Kulihrasek456/PID-thermostat-MatProject/Dokumentace/Ostatni/TestSetup.png

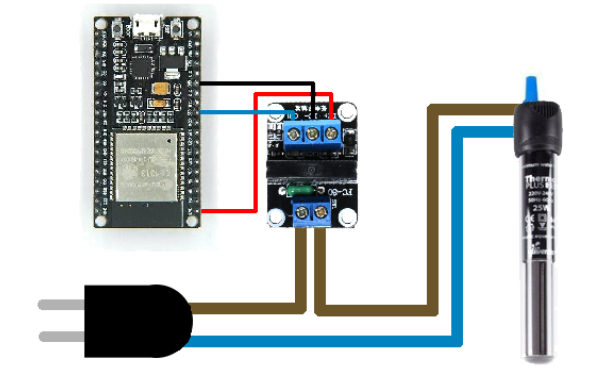
Dokumentace/Ostatni/TestSetup.png
