Kulihrasek456/PID-thermostat-MatProject/Dokumentace/Stránky/IMG_2406.jpg

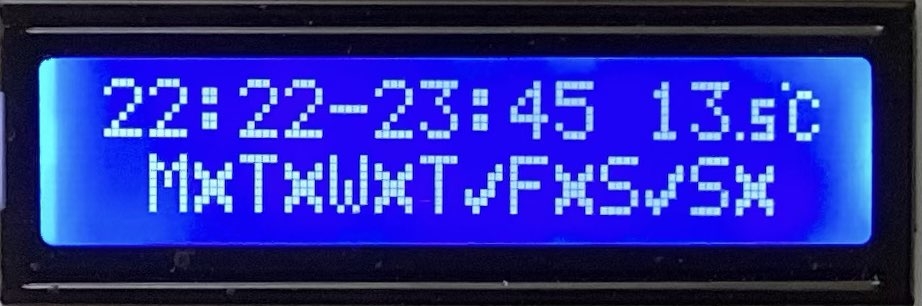
Dokumentace/Stránky/IMG_2406.jpg
