Kulihrasek456/PID-thermostat-MatProject/Dokumentace/Ostatni/1679677724410.jpg

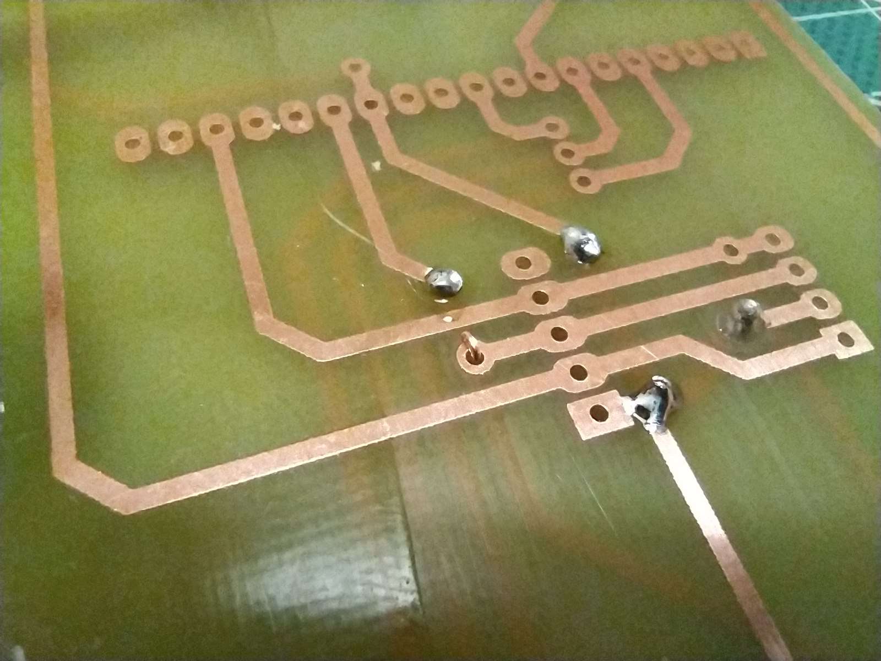
Dokumentace/Ostatni/1679677724410.jpg
