Kulihrasek456/PID-thermostat-MatProject/Dokumentace/Ostatni/1679680318831.jpg

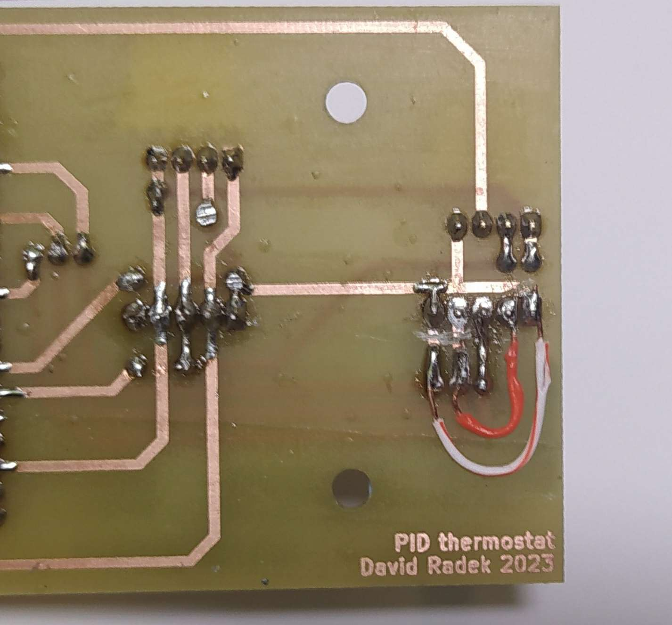
Dokumentace/Ostatni/1679680318831.jpg
