Kulihrasek456/PID-thermostat-MatProject/Dokumentace/Ostatni/Case1.png

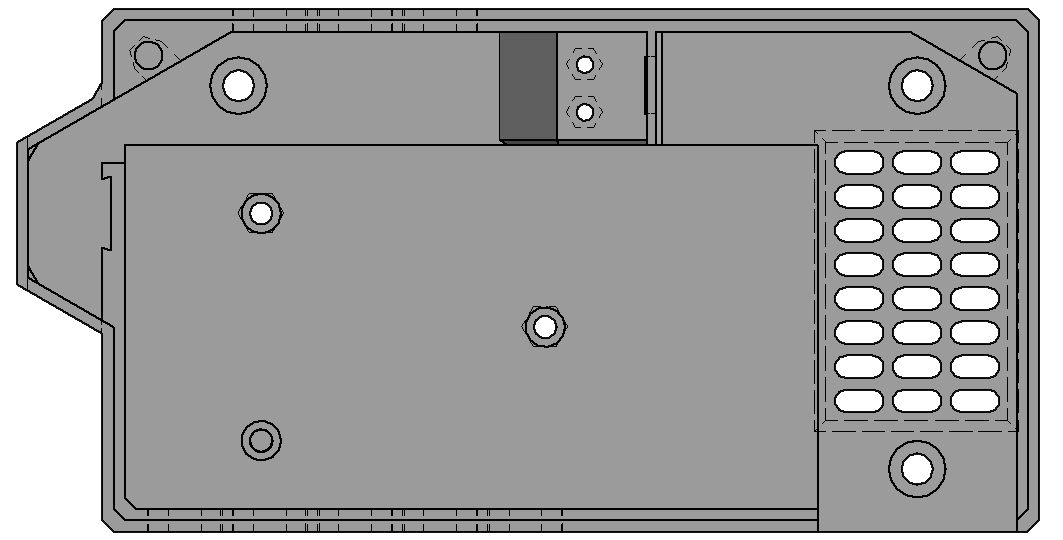
Dokumentace/Ostatni/Case1.png
