Kulihrasek456/PID-thermostat-MatProject/Dokumentace/Ostatni/Case2.png

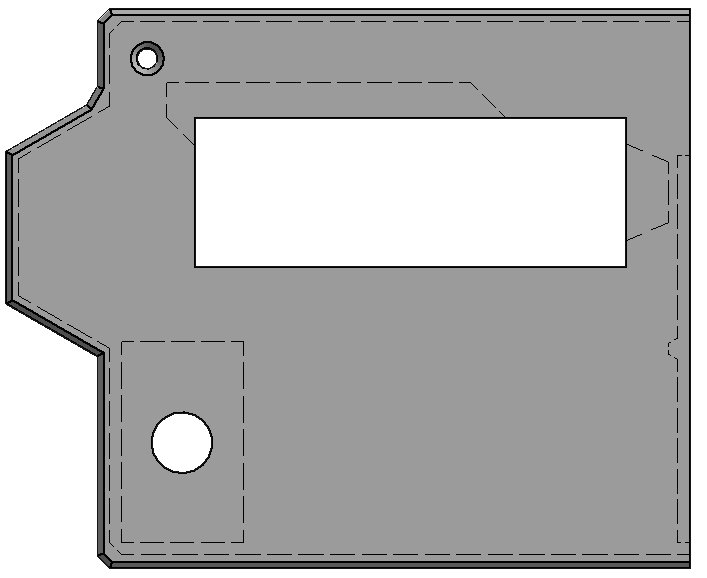
Dokumentace/Ostatni/Case2.png
