Kulihrasek456/PID-thermostat-MatProject/Dokumentace/Ostatni/Case3.png

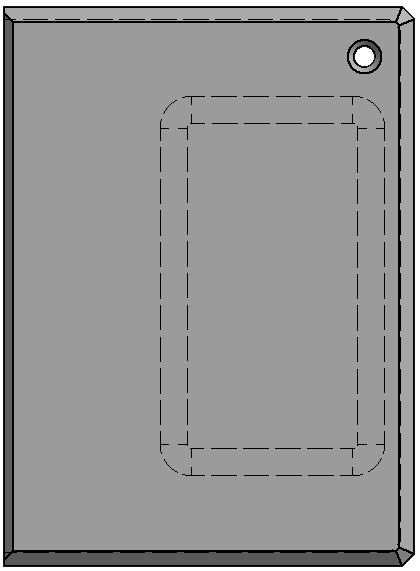
Dokumentace/Ostatni/Case3.png
