Kulihrasek456/PID-thermostat-MatProject/Dokumentace/Ostatni/CaseALl.png

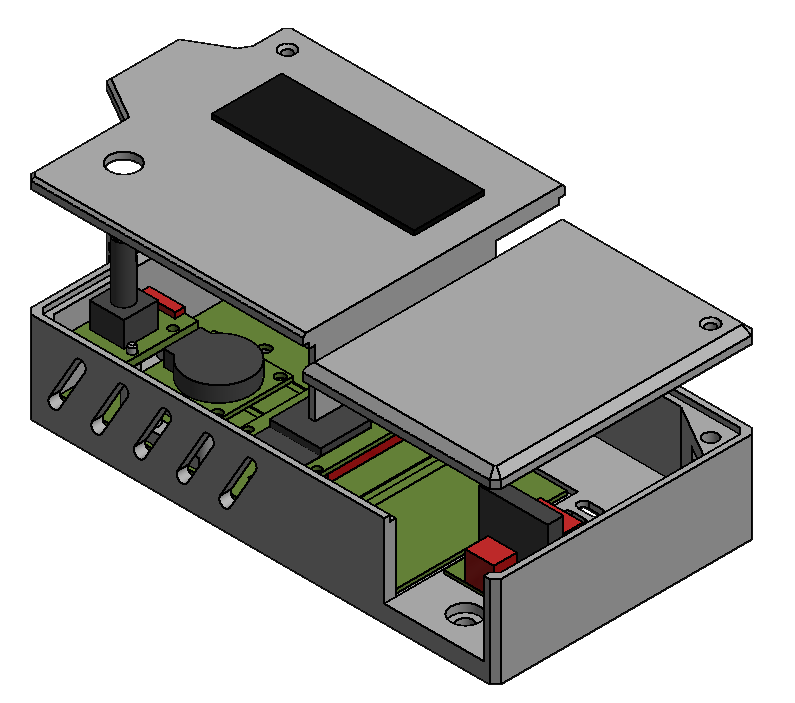
Dokumentace/Ostatni/CaseALl.png
