Kulihrasek456/PID-thermostat-MatProject/Dokumentace/Ostatni/CaseComposite.png

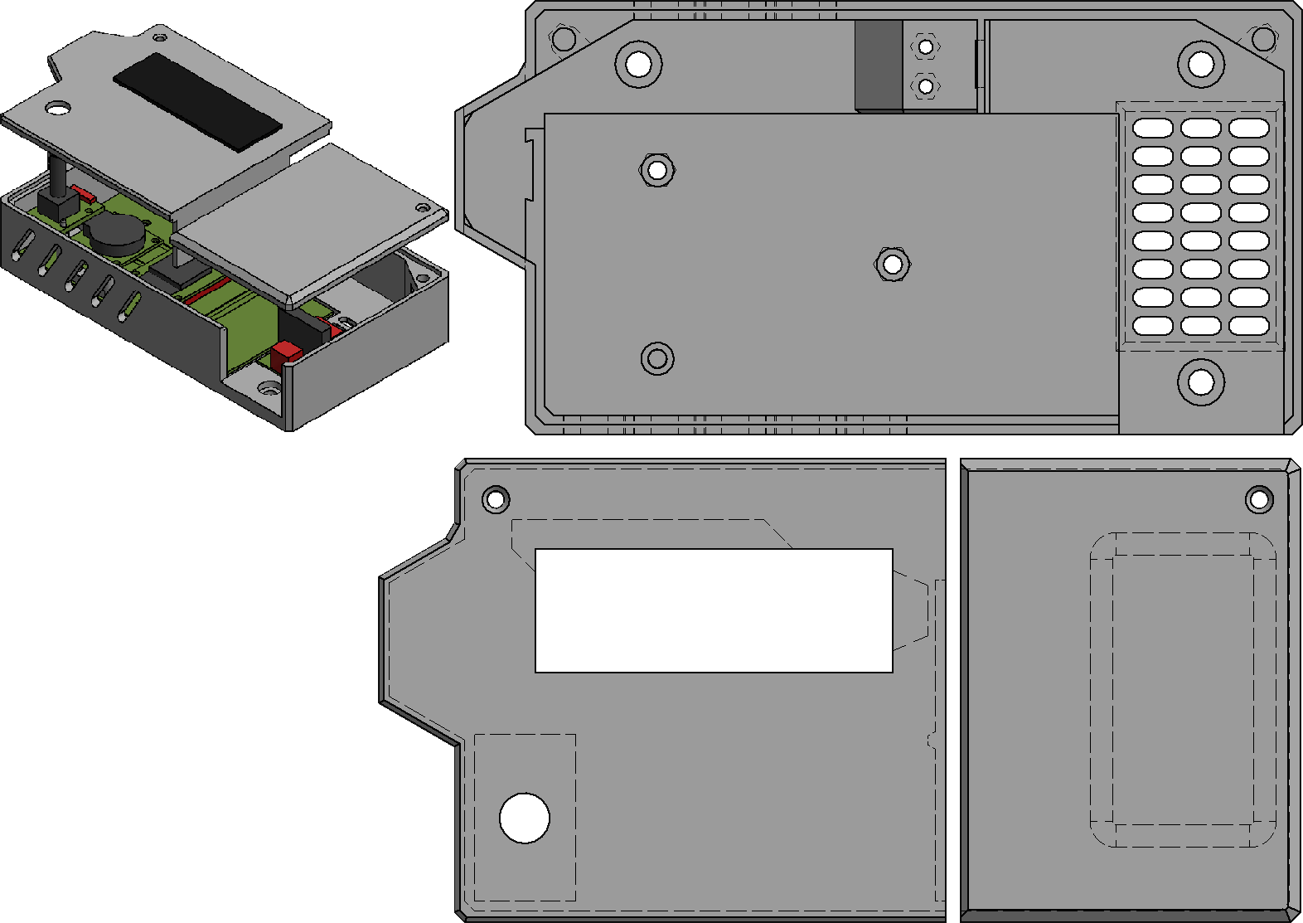
Dokumentace/Ostatni/CaseComposite.png
