Kulihrasek456/PID-thermostat-MatProject/Dokumentace/Ostatni/IMG_2393.jpg

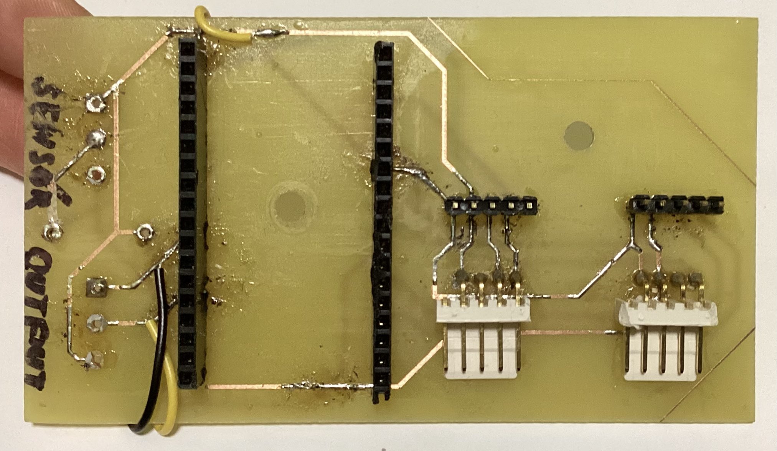
Dokumentace/Ostatni/IMG_2393.jpg
