Kulihrasek456/PID-thermostat-MatProject/Dokumentace/Ostatni/IMG_2394.jpg

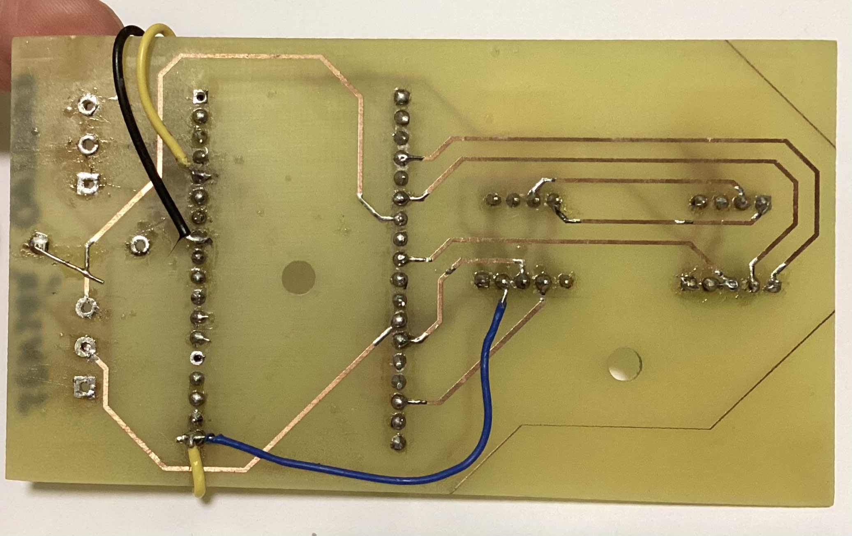
Dokumentace/Ostatni/IMG_2394.jpg
