Kulihrasek456/PID-thermostat-MatProject/Dokumentace/Ostatni/IMG_2408.jpg

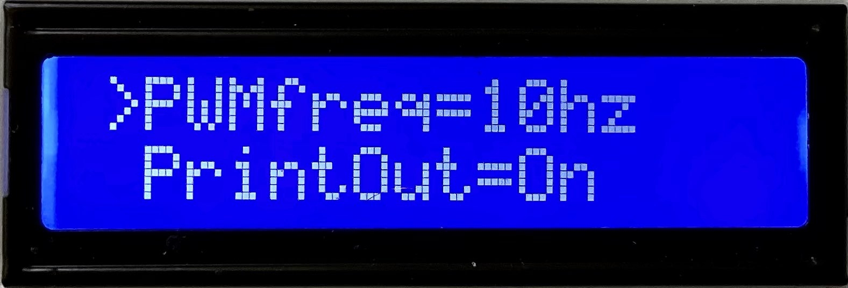
Dokumentace/Ostatni/IMG_2408.jpg
