Kulihrasek456/PID-thermostat-MatProject/Dokumentace/Ostatni/IMG_2410.jpg

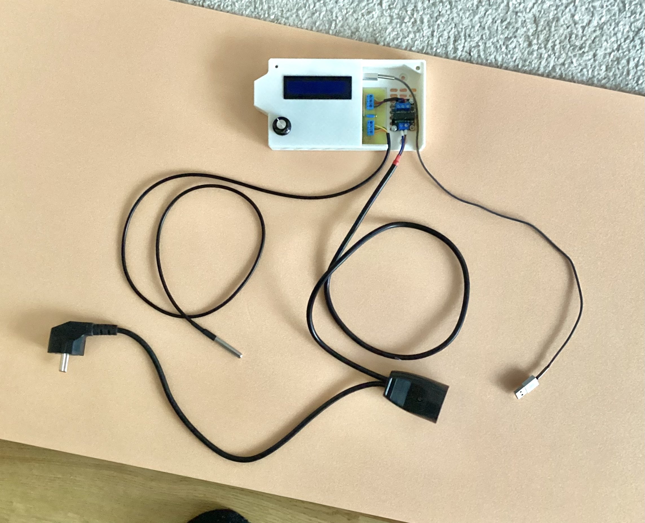
Dokumentace/Ostatni/IMG_2410.jpg
