Kulihrasek456/PID-thermostat-MatProject/Dokumentace/Ostatni/IMG_2411.jpg

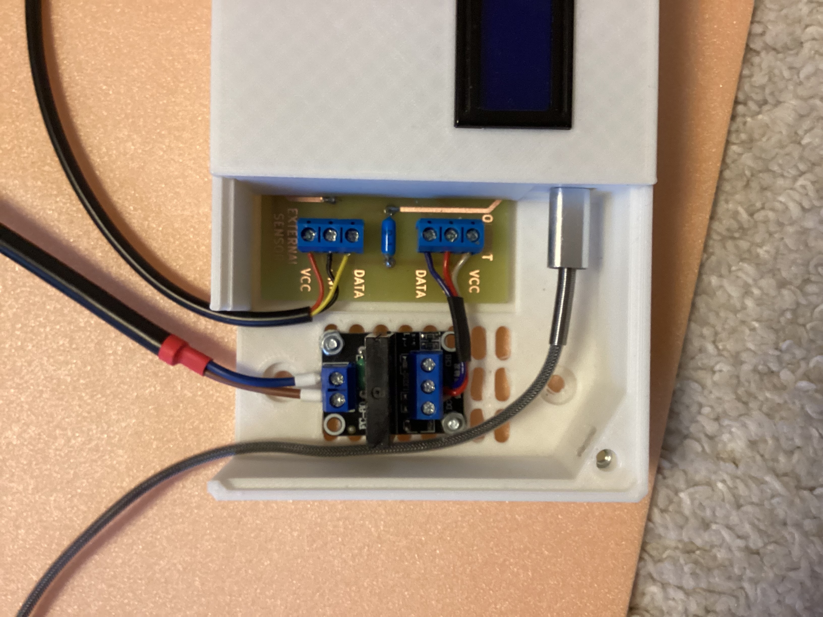
Dokumentace/Ostatni/IMG_2411.jpg
