Kulihrasek456/PID-thermostat-MatProject/Dokumentace/Ostatni/IMG_2413.jpg

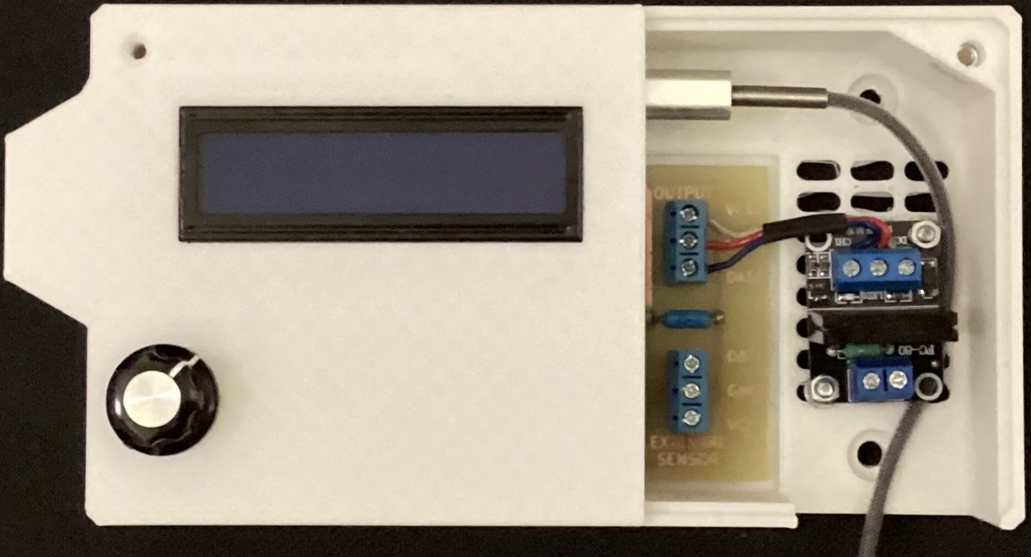
Dokumentace/Ostatni/IMG_2413.jpg
