Kulihrasek456/PID-thermostat-MatProject/Dokumentace/Ostatni/IMG_2417.jpg

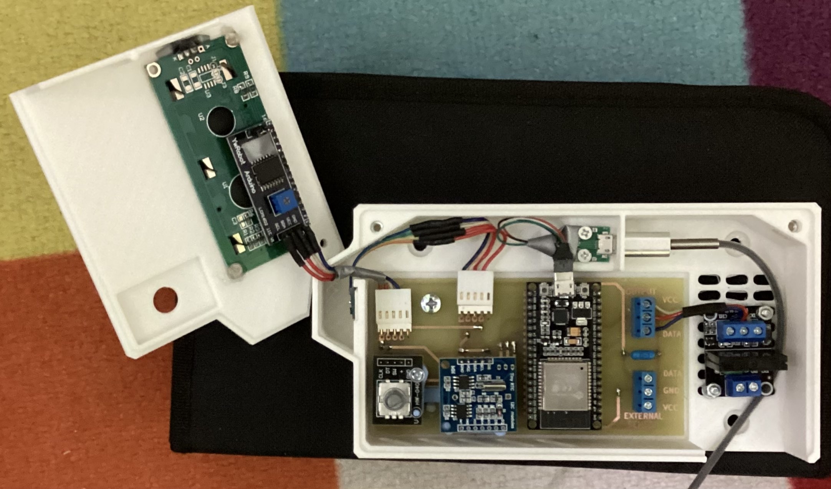
Dokumentace/Ostatni/IMG_2417.jpg
