Kulihrasek456/PID-thermostat-MatProject/Dokumentace/Ostatni/PCB_Final1.png

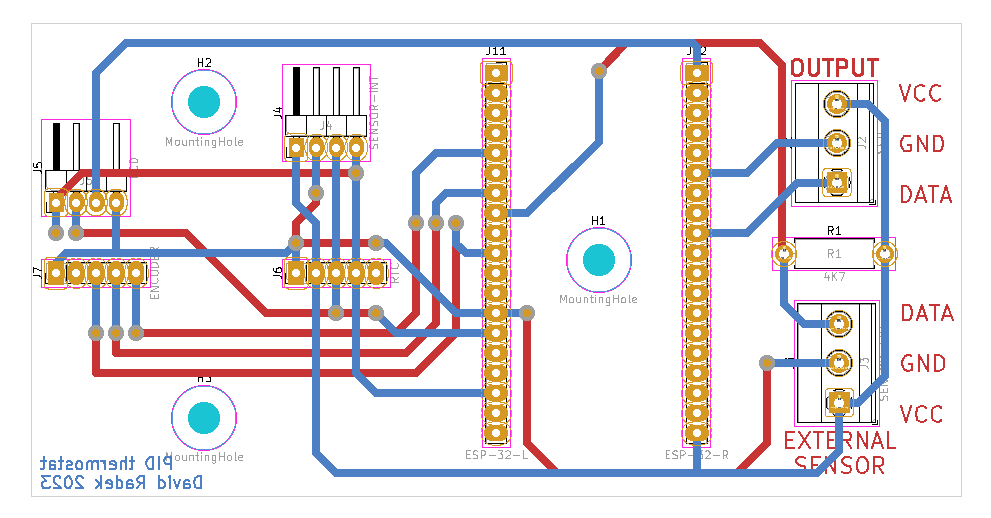
Dokumentace/Ostatni/PCB_Final1.png
