Kulihrasek456/PID-thermostat-MatProject/Dokumentace/Ostatni/PRO_rozbor.png

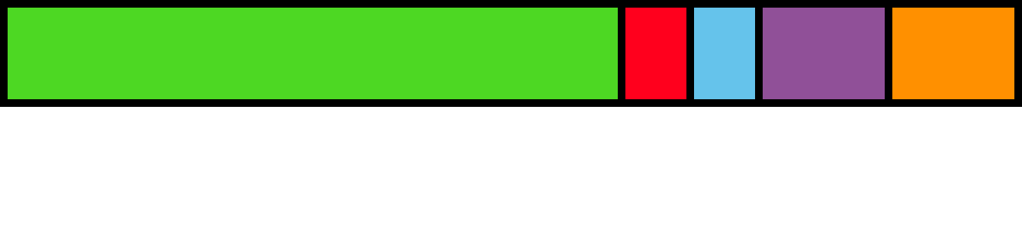
Dokumentace/Ostatni/PRO_rozbor.png
