Kulihrasek456/PID-thermostat-MatProject/Dokumentace/Ostatni/UML2.png

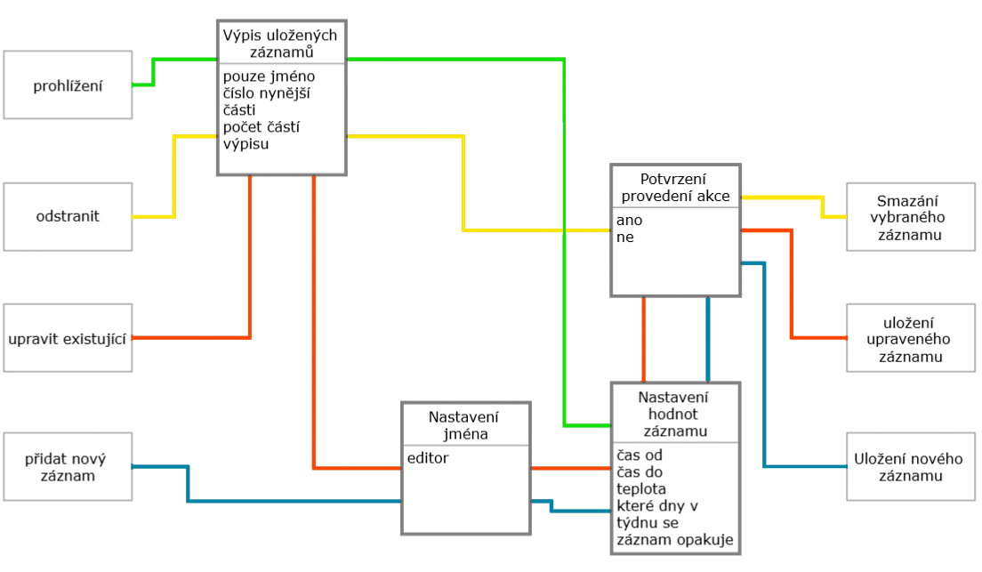
Dokumentace/Ostatni/UML2.png
