Kulihrasek456/PID-thermostat-MatProject/Dokumentace/Stránky/IMG_2404.jpg

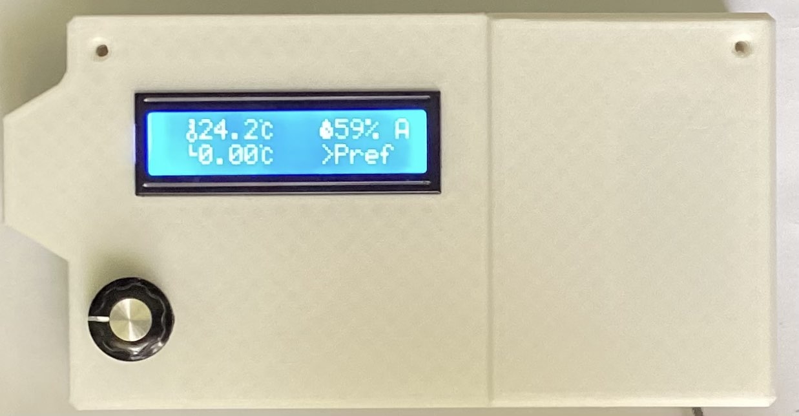
Dokumentace/Stránky/IMG_2404.jpg
