Kulihrasek456/PID-thermostat-MatProject/Dokumentace/Stránky/IMG_2405.jpg

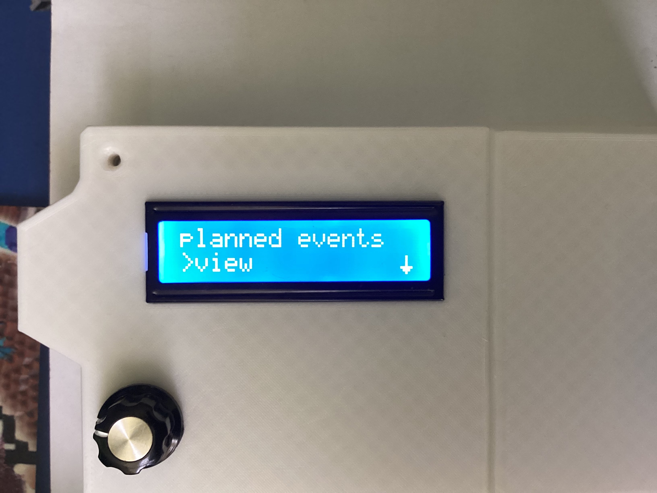
Dokumentace/Stránky/IMG_2405.jpg
