Kulihrasek456/PID-thermostat-MatProject/Dokumentace/Stránky/IMG_2407.jpg

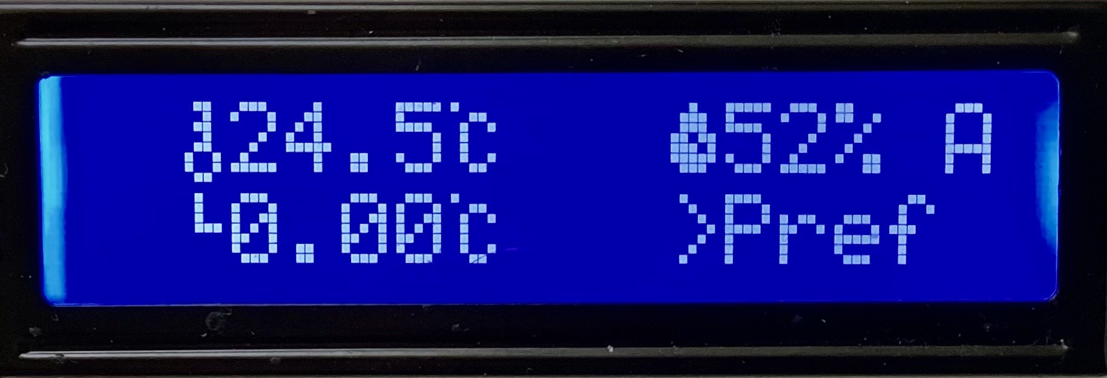
Dokumentace/Stránky/IMG_2407.jpg
