Kulihrasek456/PID-thermostat-MatProject/Dokumentace/Stránky/MainMenu.png

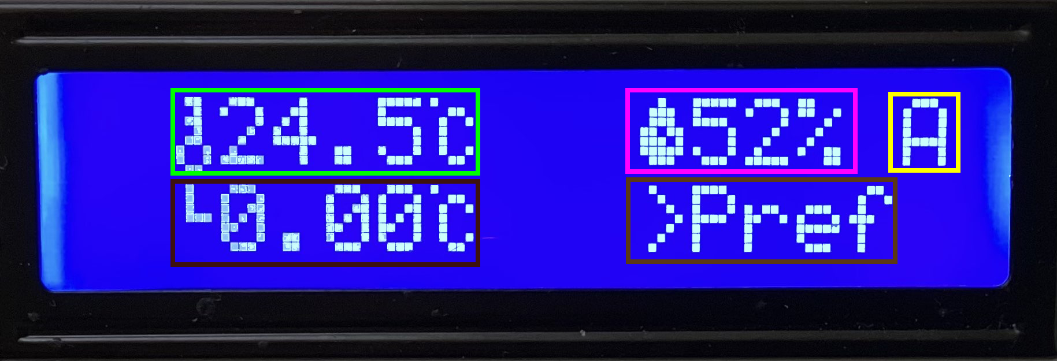
Dokumentace/Stránky/MainMenu.png
