Kulihrasek456/PID-thermostat-MatProject/Dokumentace/Stránky/Preferences.png

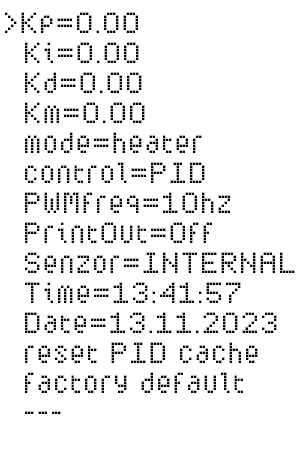
Dokumentace/Stránky/Preferences.png
