Kulihrasek456/PID-thermostat-MatProject/Final/PCB/FINAL.stl

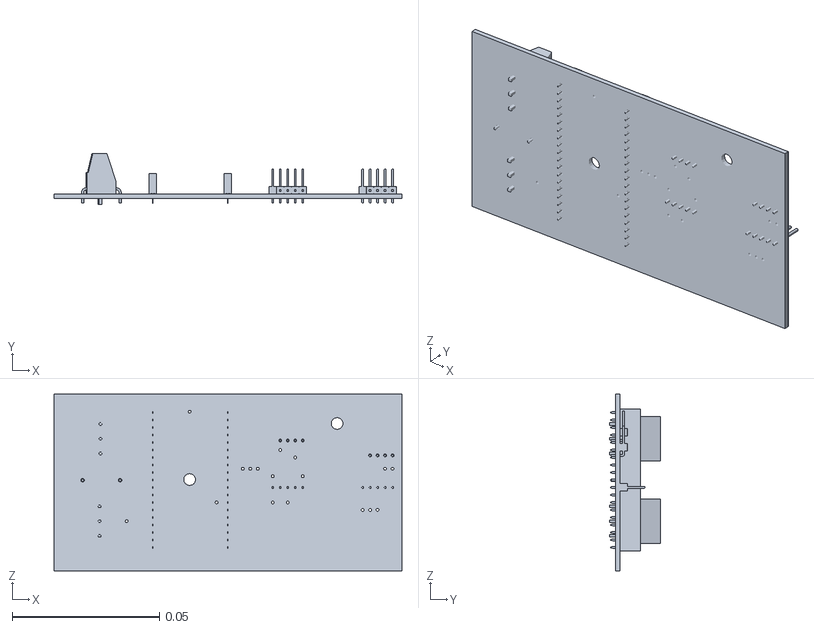
[picture p57: CAD file, 2023-04-15]
Final/PCB/FINAL.stl
0.118 x 0.0173 x 0.06
