Kulihrasek456/PID-thermostat-MatProject/Dokumentace/Ostatni/Testing.xlsx

čas | 0 | 5 | 10 | 15 | 20 | 25 | 30 | 35 | 40 | 45 | 50 | 55 | 60 | 65 | 70 | 75 | 80 | 85 | 90 | 95 | 100 | 105 | 110 | 115 | 120
nynější teplota | 23.10 | 23.15 | 23.24 | 23.36 | 23.52 | 23.70 | 23.81 | 23.89 | 23.94 | 23.97 | 23.99 | 24.02 | 24.05 | 24.07 | 24.05 | 24.03 | 24.00 | 23.97 | 23.97 | 24.00 | 23.98 | 24.02 | 24.00 | 23.98 | 24.00
požadovaná teplota | 24.00 | 24.00 | 24.00 | 24.00 | 24.00 | 24.00 | 24.00 | 24.00 | 24.00 | 24.00 | 24.00 | 24.00 | 24.00 | 24.00 | 24.00 | 24.00 | 24.00 | 24.00 | 24.00 | 24.00 | 24.00 | 24.00 | 24.00 | 24.00 | 24.00
controller output | 255.00 | 255.00 | 255.00 | 255.00 | 255.00 | 200.00 | 100.00 | 0.00 | 0.00 | 0.00 | 0.00 | 0.00 | 0.00 | 0.00 | 0.00 | 0.00 | 85.00 | 90.00 | 20.00 | 20.00 | 0.00 | 0.00 | 10.00 | 15.00 | 0.00
