Kulihrasek456/PID-thermostat-MatProject/Final/PCB/Final.kicad_pcb

## KiCad design Final/PCB/Final.kicad_pcb (2023-04-15)

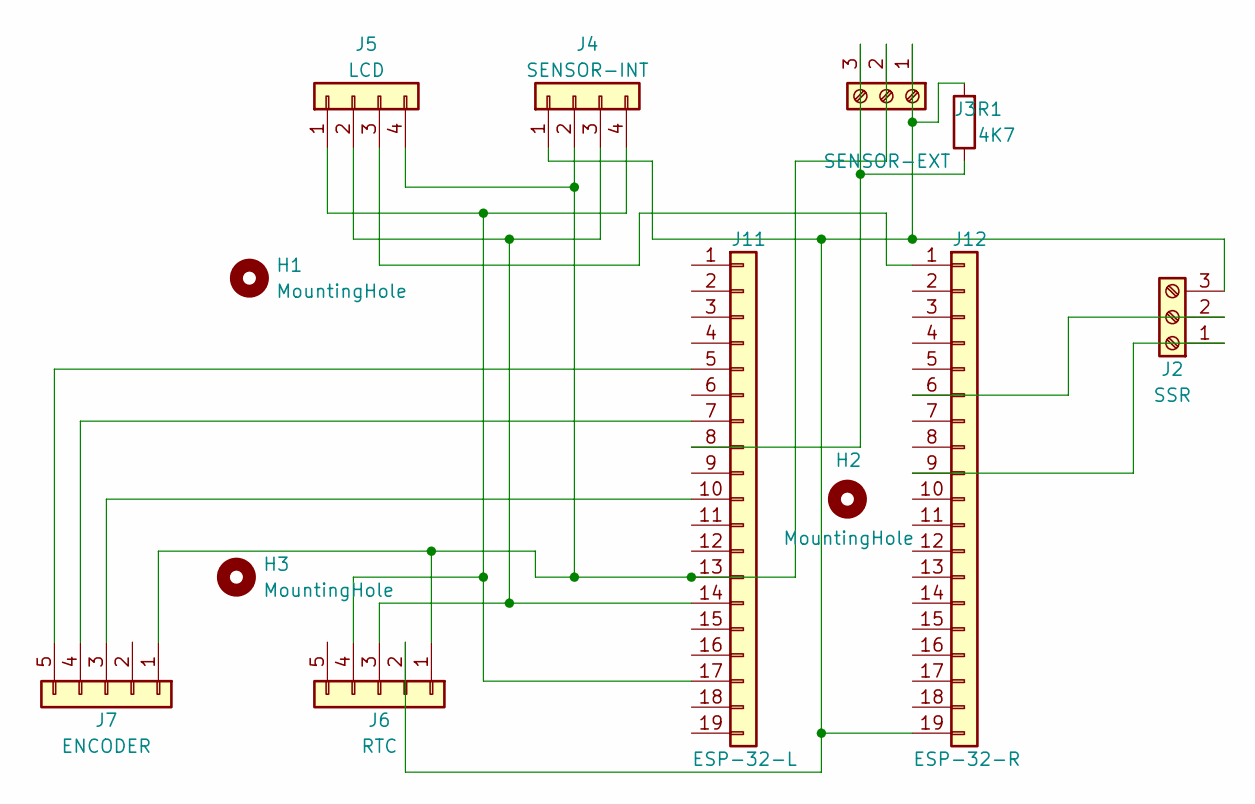
[picture p58: schematic Final.kicad_sch]

Parts:
H1, H2, H3: MountingHole; MountingHole_4mm
J2: SSR; TerminalBlock_Phoenix_MKDS-1,5-3_1x03_P5.00mm_Horizontal
J3: SENSOR-EXT; TerminalBlock_Phoenix_MKDS-1,5-3_1x03_P5.00mm_Horizontal
J4: SENSOR-INT; PinHeader_1x04_P2.54mm_Horizontal
J5: LCD; PinHeader_1x04_P2.54mm_Horizontal
J6: RTC; PinHeader_1x05_P2.54mm_Vertical
J7: ENCODER; PinHeader_1x05_P2.54mm_Vertical
J11: ESP-32-L; PinSocket_1x19_P2.54mm_Vertical
J12: ESP-32-R; PinSocket_1x19_P2.54mm_Vertical
R1: 4K7; R_Axial_DIN0411_L9.9mm_D3.6mm_P12.70mm_Horizontal

Connections:
unnamed: J7.5, J11.5 (Pin_GPIO2)
unnamed: J7.4, J11.7 (Pin_GPIO4)
unnamed: J3.3 (Pin_DATA), J11.8 (Pin_GPIO16), R1.1
unnamed: J7.3, J11.10 (Pin_GPIO5)
unnamed: J3.2 (Pin_GND), J4.2, J5.4, J6.1, J7.1, J11.13 (Pin_GND)
unnamed: J4.3, J5.2, J6.3, J11.14 (Pin_SDA)
unnamed: J4.4, J5.1, J6.4, J11.17 (Pin_SCL)
unnamed: J5.3, J12.1
unnamed: J2.2, J12.6 (Pin_GND)
unnamed: J2.1, J12.9 (Pin_GPIO27)
unnamed: J2.3, J3.1 (Pin_VCC), J4.1, J6.2, J12.19 (Pin_3V3), R1.2

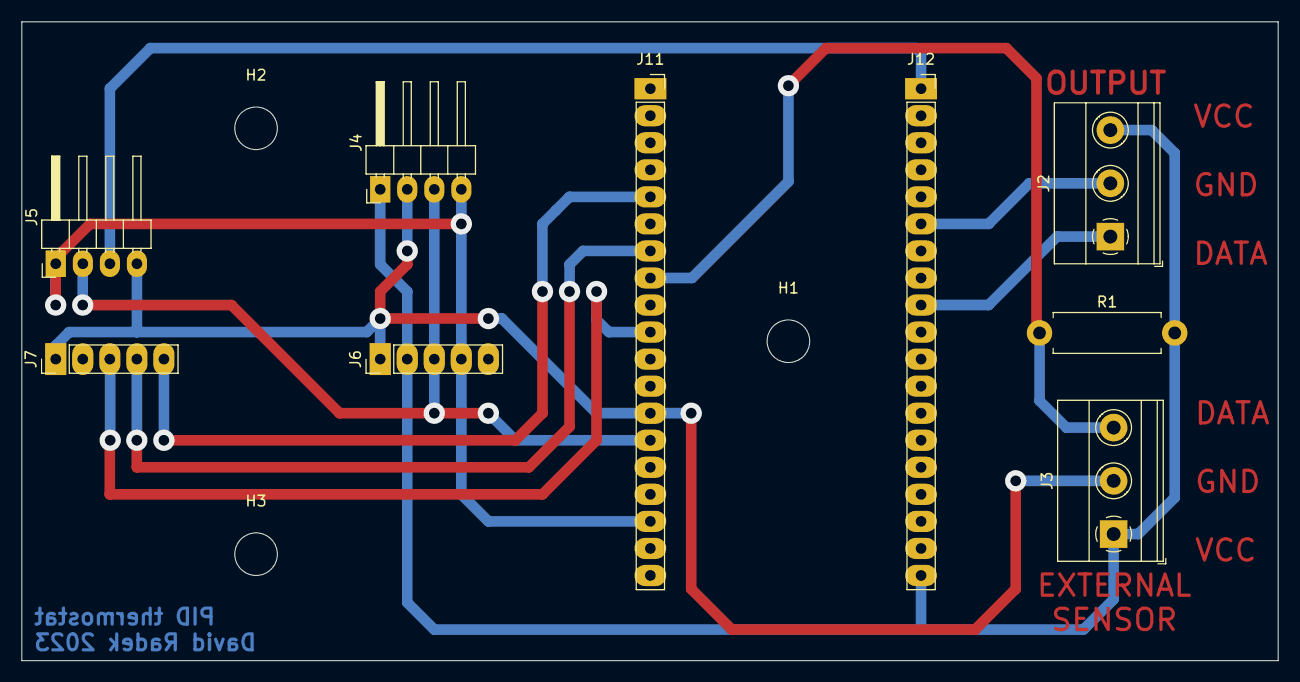
[picture p59: board Final.kicad_pcb from above]

Board: 2 copper layers, 118.0 x 60.0 mm, 12 parts (0 on the bottom side), 11 nets.
