Kulihrasek456/PID-thermostat-MatProject/Final/PIDcontroller V2.14/A0Symbols.h

//----Symbols--------------------------------


extern byte errorSymbol[] = {
  B10101,
  B01010,
  B10101,
  B01010,
  B10101,
  B01010,
  B10101,
  B01010
};
extern byte celsiusSymbol[] = {
  B10000,
  B00110,
  B01001,
  B01000,
  B01000,
  B01001,
  B00110,
  B00000
};
extern byte celsiusSymbol_inv[] = {
  B01111,
  B11001,
  B10110,
  B10111,
  B10111,
  B10110,
  B11001,
  B11111
};
extern byte returnSymbol[] = {
  B00001,
  B00001,
  B00001,
  B00101,
  B01101,
  B11110,
  B01100,
  B00100
};
extern byte returnSymbol_inv[] = {
  B11110,
  B11110,
  B11110,
  B11010,
  B10010,
  B00001,
  B10011,
  B11011
};
extern byte settingsSymbol[] = {
  B01010,
  B10001,
  B10001,
  B01110,
  B00100,
  B00100,
  B00100,
  B00100
};
extern byte settingsSymbol_inv[] = {
  B10101,
  B01110,
  B01110,
  B10001,
  B11011,
  B11011,
  B11011,
  B11011
};
extern byte saveSymbol[] = {
  B00000,
  B00001,
  B00011,
  B00010,
  B10110,
  B11100,
  B01000,
  B00000
};
extern byte saveSymbol_inv[] = {
  B11111,
  B11110,
  B11100,
  B11101,
  B01001,
  B00011,
  B10111,
  B11111
};
extern byte cancelSymbol[] = {
  B00000,
  B10001,
  B11011,
  B01110,
  B01110,
  B11011,
  B10001,
  B00000
};
extern byte cancelSymbol_inv[] = {
  B11111,
  B01110,
  B00100,
  B10001,
  B10001,
  B00100,
  B01110,
  B11111
};
extern byte temperatureSymbol[] = {
  B00110,
  B00010,
  B00110,
  B00010,
  B00110,
  B01001,
  B01001,
  B00110
};
extern byte temperatureSymbol_inv[] = {
  B11001,
  B11101,
  B11001,
  B11101,
  B11001,
  B10110,
  B10110,
  B11001
};
extern byte humiditySymbol[] = {
  B00100,
  B01110,
  B01110,
  B11011,
  B11101,
  B11111,
  B01110,
  B00000
};
extern byte humiditySymbol_inv[] = {
  B11011,
  B10001,
  B10001,
  B00100,
  B00010,
  B00000,
  B10001,
  B11111
};

extern byte thinUnderlineSymbol[] = {
  B00000,
  B00000,
  B00000,
  B00000,
  B00000,
  B00000,
  B00000,
  B11111
};

extern byte pathTopDownLeftSymbol[] = {
  B00100,
  B00100,
  B00100,
  B00111,
  B00000,
  B00000,
  B00000,
  B00000
};

extern byte pathTopDownLeftSymbolNegative[] = {
  B00100,
  B00100,
  B00100,
  B00111,
  B00000,
  B00111,
  B00000,
  B00000
};

extern byte arrowUpSymbol[] = {
  B00100,
  B01110,
  B11111,
  B00100,
  B00100,
  B00100,
  B00100,
  B00000
};

extern byte arrowDownSymbol[] = {
  B00000,
  B00100,
  B00100,
  B00100,
  B00100,
  B11111,
  B01110,
  B00100
};

extern byte blockInMiddleSymbol[] = {
  B00000,
  B00000,
  B00000,
  B11111,
  B11111,
  B00000,
  B00000,
  B00000
};

extern byte arrowDoubleSymbol[] = {
  B00100,
  B01110,
  B11111,
  B00100,
  B00100,
  B11111,
  B01110,
  B00100
};


extern byte pointFiveSymbol[] = {
  B00000,
  B00000,
  B00111,
  B00100,
  B00111,
  B00001,
  B10111,
  B00000
};

extern byte pointZeroSymbol[] = {
  B00000,
  B00000,
  B00111,
  B00101,
  B00101,
  B00101,
  B10111,
  B00000
};
