Kulihrasek456/PID-thermostat-MatProject/(commit log)

2023-04-15 Nahrání finálních verzí souborů
    [FINAL.stl, Final.kicad_pcb, Final.kicad_sch, Testing.xlsx]
2023-04-16 Final bug fixes 3
    [ComplementaryFunc.h]
